oran-srfr/k-car-stm32f103c8t6/_k_figs/image12.png

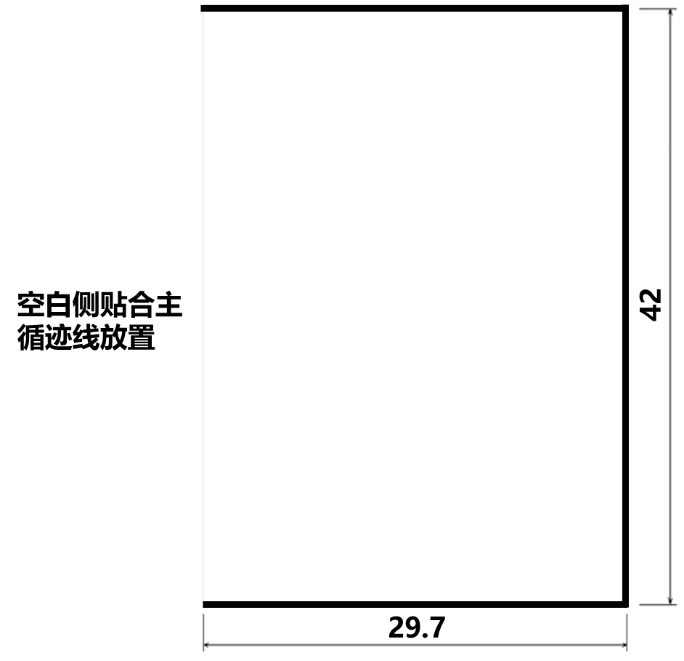
_k_figs/image12.png
