oran-srfr/k-car-stm32f103c8t6/firmware/Core/Src/line_follow.c

#include "line_follow.h"

#include <math.h>
#include <stddef.h>
#include <stdint.h>

static LineFollowState_t s_state = LINE_FOLLOW_STOPPED;
static LineFollowFault_t s_fault = LINE_FOLLOW_FAULT_NONE;
static float s_last_valid_deviation = 0.0f;
static int8_t s_last_valid_direction = 0;
static uint8_t s_has_valid_history = 0U;
static uint16_t s_lost_cycles = 0U;
static uint16_t s_reacquire_cycles = 0U;
static float s_previous_base_speed = 0.0f;
static float s_reacquire_start_base = 0.0f;
static uint16_t s_curve_hold_cycles = 0U;
static uint16_t s_centered_cycles = 0U;
static float s_previous_correction = 0.0f;
static LineFollowResult_t s_latest_output;

static void LineFollow_ResetState(LineFollowState_t state)
{
  s_state = state;
  s_fault = LINE_FOLLOW_FAULT_NONE;
  s_last_valid_deviation = 0.0f;
  s_last_valid_direction = 0;
  s_has_valid_history = 0U;
  s_lost_cycles = 0U;
  s_reacquire_cycles = 0U;
  s_previous_base_speed = 0.0f;
  s_reacquire_start_base = 0.0f;
  s_curve_hold_cycles = 0U;
  s_centered_cycles = 0U;
  s_previous_correction = 0.0f;

  s_latest_output = (LineFollowResult_t){0};
  s_latest_output.state = state;
  s_latest_output.control.track.status = LINE_TRACK_STATUS_LOST;
  s_latest_output.control.pd.status = LINE_TRACK_STATUS_LOST;
  s_latest_output.control.control_status = LINE_CONTROL_STATUS_DISABLED_STOP;
  PDController_Reset();
}

static uint8_t LineFollow_ConfigIsValid(const MotorCommandConfig_t *motor_config,
                                        const LineFollowConfig_t *follow_config)
{
  if ((motor_config == NULL) || (follow_config == NULL))
  {
    return 0U;
  }

  if (!isfinite(motor_config->base_speed) ||
      !isfinite(motor_config->max_forward_command) ||
      !isfinite(motor_config->min_forward_command) ||
      !isfinite(motor_config->straight_trim) ||
      !isfinite(follow_config->curve_speed) ||
      !isfinite(follow_config->sharp_curve_speed) ||
      !isfinite(follow_config->search_speed) ||
      !isfinite(follow_config->straight_max_deviation) ||
      !isfinite(follow_config->curve_max_deviation) ||
      !isfinite(follow_config->search_turn_correction))
  {
    return 0U;
  }

  if ((motor_config->min_forward_command <= 0.0f) ||
      (motor_config->max_forward_command <= motor_config->min_forward_command) ||
      (motor_config->base_speed < motor_config->min_forward_command) ||
      (motor_config->base_speed > motor_config->max_forward_command) ||
      (follow_config->curve_speed < motor_config->min_forward_command) ||
      (follow_config->curve_speed > motor_config->base_speed) ||
      (follow_config->sharp_curve_speed < motor_config->min_forward_command) ||
      (follow_config->sharp_curve_speed > follow_config->curve_speed) ||
      (follow_config->search_speed < motor_config->min_forward_command) ||
      (follow_config->search_speed > motor_config->max_forward_command) ||
      (follow_config->straight_max_deviation < 0.0f) ||
      (follow_config->curve_max_deviation < follow_config->straight_max_deviation) ||
      (follow_config->search_turn_correction < 0.0f))
  {
    return 0U;
  }

  return 1U;
}

static float LineFollow_SelectBaseSpeed(float deviation,
                                        const MotorCommandConfig_t *motor_config,
                                        const LineFollowConfig_t *follow_config)
{
  float absolute_deviation = fabsf(deviation);

  if (absolute_deviation <= follow_config->straight_max_deviation)
  {
    /* Centered samples occur throughout an arc; do not accelerate on each. */
    if (s_curve_hold_cycles > 0U)
    {
      --s_curve_hold_cycles;
      return follow_config->curve_speed;
    }
    return motor_config->base_speed;
  }
  s_curve_hold_cycles = LINE_FOLLOW_CURVE_HOLD_CYCLES;
  if (absolute_deviation <= follow_config->curve_max_deviation)
  {
    return follow_config->curve_speed;
  }
  return follow_config->sharp_curve_speed;
}

/* Rate limit steering, not individual wheels: stale steering must never keep
 * pointing away from a line that has reappeared on the opposite side. */
static float LineFollow_LimitCorrection(float target)
{
  float delta;
  if (target * s_previous_correction < 0.0f) {
    s_previous_correction = 0.0f;
  }
  delta = target - s_previous_correction;
  if (delta > LINE_FOLLOW_CORRECTION_STEP) delta = LINE_FOLLOW_CORRECTION_STEP;
  if (delta < -LINE_FOLLOW_CORRECTION_STEP) delta = -LINE_FOLLOW_CORRECTION_STEP;
  s_previous_correction += delta;
  return s_previous_correction;
}

static MotorCommandResult_t LineFollow_MakeCommand(float base_speed,
                                                    float correction,
                                                    const MotorCommandConfig_t *motor_config)
{
  MotorCommandConfig_t command_config = *motor_config;

  command_config.base_speed = base_speed;
  /* 找线命令由状态机授权，仍复用已有左右轮混合和限幅函数。 */
  return MotorCommand_Calculate(LINE_TRACK_STATUS_NORMAL,
                                LineFollow_LimitCorrection(correction),
                                &command_config);
}

static void LineFollow_SetFault(LineFollowFault_t fault,
                                LineFollowResult_t *result)
{
  s_state = LINE_FOLLOW_FAULT;
  s_fault = fault;
  s_reacquire_cycles = 0U;
  s_previous_correction = 0.0f;
  result->base_speed = 0.0f;
  result->left_command = 0.0f;
  result->right_command = 0.0f;
}

static void LineFollow_UpdateLastDeviation(float deviation)
{
  s_last_valid_deviation = deviation;
  s_has_valid_history = 1U;

  if (deviation < 0.0f)
  {
    s_last_valid_direction = -1;
    s_centered_cycles = 0U;
  }
  else if (deviation > 0.0f)
  {
    s_last_valid_direction = 1;
    s_centered_cycles = 0U;
  }
  else {
    if (s_centered_cycles < LINE_FOLLOW_DIRECTION_HOLD_CYCLES) ++s_centered_cycles;
    if (s_centered_cycles >= LINE_FOLLOW_DIRECTION_HOLD_CYCLES) {
      s_last_valid_direction = 0;
    }
  }
  /* Keep direction through short centered arc samples, but expire it after
   * a sustained straight. A later gap must not resurrect an old bend. */
}

static void LineFollow_HandleLost(const MotorCommandConfig_t *motor_config,
                                  const LineFollowConfig_t *follow_config,
                                  LineFollowResult_t *result)
{
  MotorCommandResult_t motor;
  float search_correction;

  if (s_has_valid_history == 0U)
  {
    LineFollow_SetFault(LINE_FOLLOW_FAULT_NO_VALID_HISTORY, result);
    return;
  }

  if (s_lost_cycles < UINT16_MAX)
  {
    ++s_lost_cycles;
  }

  if (s_lost_cycles > follow_config->max_lost_cycles)
  {
    LineFollow_SetFault(LINE_FOLLOW_FAULT_LOST_TIMEOUT, result);
    return;
  }

  s_state = (s_lost_cycles == 1U) ? LINE_FOLLOW_LINE_LOST
                                  : LINE_FOLLOW_SEARCHING;
  s_reacquire_cycles = 0U;
  s_centered_cycles = 0U;
  result->base_speed = follow_config->search_speed;
  search_correction = follow_config->search_turn_correction *
                      (float)s_last_valid_direction;
  motor = LineFollow_MakeCommand(result->base_speed,
                                 search_correction,
                                 motor_config);
  result->left_command = motor.left_command;
  result->right_command = motor.right_command;
}

static void LineFollow_HandleNormal(const MotorCommandConfig_t *motor_config,
                                    const LineFollowConfig_t *follow_config,
                                    LineFollowResult_t *result)
{
  MotorCommandResult_t motor;
  float target_base;
  float alpha;

  target_base = LineFollow_SelectBaseSpeed(result->control.track.deviation,
                                           motor_config,
                                           follow_config);

  if ((s_state == LINE_FOLLOW_LINE_LOST) ||
      (s_state == LINE_FOLLOW_SEARCHING))
  {
    s_state = LINE_FOLLOW_REACQUIRE;
    s_reacquire_cycles = 0U;
    s_reacquire_start_base = s_previous_base_speed;
  }

  LineFollow_UpdateLastDeviation(result->control.track.deviation);

  if (s_state != LINE_FOLLOW_REACQUIRE)
  {
    s_state = LINE_FOLLOW_TRACKING;
    s_lost_cycles = 0U;
    if ((s_previous_base_speed > 0.0f) &&
        (target_base > s_previous_base_speed + LINE_FOLLOW_BASE_STEP))
    {
      target_base = s_previous_base_speed + LINE_FOLLOW_BASE_STEP;
    }
    motor = LineFollow_MakeCommand(target_base, result->control.pd.output,
                                    motor_config);
    result->base_speed = target_base;
    result->left_command = motor.left_command;
    result->right_command = motor.right_command;
    return;
  }

  if (follow_config->reacquire_cycles == 0U)
  {
    alpha = 1.0f;
  }
  else
  {
    if (s_reacquire_cycles < UINT16_MAX)
    {
      ++s_reacquire_cycles;
    }
    alpha = (float)s_reacquire_cycles /
            (float)follow_config->reacquire_cycles;
    if (alpha > 1.0f)
    {
      alpha = 1.0f;
    }
  }

  result->base_speed = s_reacquire_start_base +
                       alpha * (target_base - s_reacquire_start_base);
  /* Smooth only forward speed. Blending old wheel commands can keep turning
   * toward the lost-line side even after the line reappears on the other side. */
  motor = LineFollow_MakeCommand(result->base_speed, result->control.pd.output,
                                  motor_config);
  result->left_command = motor.left_command;
  result->right_command = motor.right_command;

  if ((follow_config->reacquire_cycles == 0U) ||
      (s_reacquire_cycles >= follow_config->reacquire_cycles))
  {
    s_state = LINE_FOLLOW_TRACKING;
    s_lost_cycles = 0U;
  }
}

/** 初始化后保持停止，防止复位后产生非零命令。 */
void LineFollow_Init(void)
{
  LineFollow_ResetState(LINE_FOLLOW_STOPPED);
}

/** 清除状态机历史并等待下一次有效采样。 */
void LineFollow_Start(void)
{
  LineFollow_ResetState(LINE_FOLLOW_TRACKING);
}

/** 停止状态机并清除所有可输出的软件命令历史。 */
void LineFollow_Stop(void)
{
  LineFollow_ResetState(LINE_FOLLOW_STOPPED);
}

/** 执行一次循迹状态机，不访问 PWM、方向 GPIO 或电机驱动。 */
LineFollowResult_t LineFollow_Update(const PDControllerConfig_t *pd_config,
                                     const MotorCommandConfig_t *motor_config,
                                     const LineFollowConfig_t *follow_config)
{
  LineFollowResult_t result;

  result.control = LineControl_Sample(pd_config);
  result.base_speed = 0.0f;
  result.left_command = 0.0f;
  result.right_command = 0.0f;

  if (s_state == LINE_FOLLOW_STOPPED)
  {
    /* 保持采样供调试观察，但停止状态绝不生成轮命令。 */
  }
  else if (s_state == LINE_FOLLOW_FAULT)
  {
    /* 故障锁存，必须重新 Start 或先 Stop 后再 Start。 */
  }
  else if (result.control.track.status == LINE_TRACK_STATUS_ALL_BLACK)
  {
    LineFollow_SetFault(LINE_FOLLOW_FAULT_ALL_BLACK, &result);
  }
  else if ((LineFollow_ConfigIsValid(motor_config, follow_config) == 0U) ||
           (result.control.control_status == LINE_CONTROL_STATUS_INVALID_INPUT_STOP))
  {
    LineFollow_SetFault(LINE_FOLLOW_FAULT_INVALID_INPUT, &result);
  }
  else if (result.control.track.status == LINE_TRACK_STATUS_LOST)
  {
    LineFollow_HandleLost(motor_config, follow_config, &result);
  }
  else if (result.control.track.status == LINE_TRACK_STATUS_NORMAL)
  {
    LineFollow_HandleNormal(motor_config, follow_config, &result);
  }
  else
  {
    LineFollow_SetFault(LINE_FOLLOW_FAULT_INVALID_INPUT, &result);
  }

  s_previous_base_speed = result.base_speed;

  result.state = s_state;
  result.fault = s_fault;
  result.last_valid_deviation = s_last_valid_deviation;
  result.last_valid_direction = s_last_valid_direction;
  result.lost_cycles = s_lost_cycles;
  result.reacquire_cycles = s_reacquire_cycles;
  s_latest_output = result;
  return result;
}

/** 读取缓存结果，不触发新的传感器采样或控制运算。 */
LineFollowResult_t LineFollow_GetOutput(void)
{
  return s_latest_output;
}
