oran-srfr/k-car-stm32f103c8t6/firmware/Core/Inc/lcdfont.h

/* ============================================================================
 * lcdfont.h —— 8x16 ASCII 点阵字库（96 个可打印字符）
 *
 * 来源：1.8 寸 TFT 参考包 lcdfont.h，只保留 8x16 一套。
 * 原包还有 6x12 / 12x24 / 16x32 三套，全编进来约 12.2KB，64KB Flash 下没必要，
 * 需要时再放开。中文不在这里 —— 中文走外部字库芯片（zk.c）。
 *
 * 每个字符 16 字节：高 8 位在前，从左到右按列扫描，共 8 列 x 16 行。
 * ========================================================================== */

#ifndef __LCDFONT_H
#define __LCDFONT_H
const unsigned char ascii_1608[][16] =
{
	{0x00, 0x00, 0x00, 0x00, 0x00, 0x00, 0x00, 0x00, 0x00, 0x00, 0x00, 0x00, 0x00, 0x00, 0x00, 0x00}, /*" ",0*/
	{0x00, 0x00, 0x00, 0x08, 0x08, 0x08, 0x08, 0x08, 0x08, 0x08, 0x00, 0x00, 0x18, 0x18, 0x00, 0x00}, /*"!",1*/
	{0x00, 0x48, 0x6C, 0x24, 0x12, 0x00, 0x00, 0x00, 0x00, 0x00, 0x00, 0x00, 0x00, 0x00, 0x00, 0x00}, /*""",2*/
	{0x00, 0x00, 0x00, 0x24, 0x24, 0x24, 0x7F, 0x12, 0x12, 0x12, 0x7F, 0x12, 0x12, 0x12, 0x00, 0x00}, /*"#",3*/
	{0x00, 0x00, 0x08, 0x1C, 0x2A, 0x2A, 0x0A, 0x0C, 0x18, 0x28, 0x28, 0x2A, 0x2A, 0x1C, 0x08, 0x08}, /*"$",4*/
	{0x00, 0x00, 0x00, 0x22, 0x25, 0x15, 0x15, 0x15, 0x2A, 0x58, 0x54, 0x54, 0x54, 0x22, 0x00, 0x00}, /*"%",5*/
	{0x00, 0x00, 0x00, 0x0C, 0x12, 0x12, 0x12, 0x0A, 0x76, 0x25, 0x29, 0x11, 0x91, 0x6E, 0x00, 0x00}, /*"&",6*/
	{0x00, 0x06, 0x06, 0x04, 0x03, 0x00, 0x00, 0x00, 0x00, 0x00, 0x00, 0x00, 0x00, 0x00, 0x00, 0x00}, /*"'",7*/
	{0x00, 0x40, 0x20, 0x10, 0x10, 0x08, 0x08, 0x08, 0x08, 0x08, 0x08, 0x10, 0x10, 0x20, 0x40, 0x00}, /*"(",8*/
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
	{0x00, 0x00, 0x00, 0x3F, 0x42, 0x12, 0x12, 0x1E, 0x12, 0x12, 0x02, 0x02, 0x02, 0x07, 0x00, 0x00}, /*"F",38*/
	{0x00, 0x00, 0x00, 0x3C, 0x22, 0x22, 0x01, 0x01, 0x01, 0x71, 0x21, 0x22, 0x22, 0x1C, 0x00, 0x00}, /*"G",39*/
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
};
#endif /* __LCDFONT_H */
