oran-srfr/k-car-stm32f103c8t6/firmware/tests/test_tracking.c

#include "line_track.h"
#include "motor_command.h"
#include "pd_controller.h"

#include <assert.h>
#include <math.h>
#include <stdio.h>

static void test_line_track(void)
{
    LineTrackResult_t r;

    r = LineTrack_Calculate(0x0FU);
    assert(r.status == LINE_TRACK_STATUS_LOST);
    assert(r.black_bits == 0U);

    r = LineTrack_Calculate(0x00U);
    assert(r.status == LINE_TRACK_STATUS_ALL_BLACK);

    /* X1 and X3 are the two inner sensors, so their pair is centered. */
    r = LineTrack_Calculate(0x0AU);
    assert(r.status == LINE_TRACK_STATUS_NORMAL);
    assert(r.black_bits == 0x06U);
    assert(r.deviation == 0.0f);

    r = LineTrack_Calculate(0x0DU);
    assert(r.black_bits == 0x01U);
    assert(r.deviation == -3.0f);

    r = LineTrack_Calculate(0x07U);
    assert(r.black_bits == 0x08U);
    assert(r.deviation == 3.0f);
}

static void test_pd(void)
{
    PDControllerConfig_t config = { 2.0f, 10.0f, 100.0f };
    PDControllerResult_t r;

    PDController_Reset();
    r = PDController_Calculate(LINE_TRACK_STATUS_NORMAL, 1.0f, &config);
    assert(r.status == LINE_TRACK_STATUS_NORMAL);
    assert(r.output == 2.0f);
    assert(r.derivative == 0.0f);

    r = PDController_Calculate(LINE_TRACK_STATUS_NORMAL, 2.0f, &config);
    assert(r.derivative > 0.0f);
    assert(r.output > 2.0f);
    assert(r.output <= config.output_limit);

    r = PDController_Calculate(LINE_TRACK_STATUS_LOST, 5.0f, &config);
    assert(r.output == 0.0f);
}

static void test_motor_command(void)
{
    MotorCommandConfig_t config = { 20.0f, 100.0f, 0.0f, 0.0f };
    MotorCommandResult_t r;

    r = MotorCommand_Calculate(LINE_TRACK_STATUS_NORMAL, 5.0f, &config);
    assert(r.left_command == 25.0f);
    assert(r.right_command == 15.0f);

    r = MotorCommand_Calculate(LINE_TRACK_STATUS_NORMAL, 200.0f, &config);
    assert(r.left_command == 100.0f);
    assert(r.right_command == 0.0f);

    config = (MotorCommandConfig_t){650.0f, 800.0f, 550.0f, 0.0f};
    for (int correction = -500; correction <= 500; ++correction) {
        r = MotorCommand_Calculate(LINE_TRACK_STATUS_NORMAL, (float)correction, &config);
        assert(r.left_command >= 550.0f && r.left_command <= 800.0f);
        assert(r.right_command >= 550.0f && r.right_command <= 800.0f);
        assert((r.left_command - r.right_command) * correction >= 0.0f);
    }
    config.straight_trim = 10.0f;
    r = MotorCommand_Calculate(LINE_TRACK_STATUS_NORMAL, 0.0f, &config);
    assert(r.left_command == 660.0f && r.right_command == 640.0f);
    config.base_speed = 0.0f;
    r = MotorCommand_Calculate(LINE_TRACK_STATUS_NORMAL, 0.0f, &config);
    assert(r.left_command == 0.0f && r.right_command == 0.0f);
    config.base_speed = 650.0f;
    config.min_forward_command = NAN;
    r = MotorCommand_Calculate(LINE_TRACK_STATUS_NORMAL, 0.0f, &config);
    assert(r.left_command == 0.0f && r.right_command == 0.0f);

    r = MotorCommand_Calculate(LINE_TRACK_STATUS_LOST, 5.0f, &config);
    assert(r.left_command == 0.0f);
    assert(r.right_command == 0.0f);
}

int main(void)
{
    test_line_track();
    test_pd();
    test_motor_command();
    puts("PASS: tracking geometry, PD, and motor mixing");
    return 0;
}
