oran-srfr/k-car-stm32f103c8t6/(commit log)

2026-10-26 Initial STM32F103C8T6 smart car project
2026-10-26 Add competition application framework and module interfaces
2026-10-26 Add nonblocking HC-SR04 driver using TIM4 and PA4/PA5
2026-10-26 Add nonblocking TIM2 buzzer patterns and event integration
    [app_modules.c, buzzer.c, buzzer.h, buzzer_port.h, buzzer_stm32.c, test_buzzer.c]
2026-10-27 Integrate line following and fix active-low buzzer
    [app_modules.c, board_pins.h, buzzer_port.h, buzzer_stm32.c, control_config.h, line_control.c, line_control.h, line_follow.c]
2026-10-29 Stabilize forward line tracking within 55-80 percent PWM
    [app_modules.c, board_pins.h, control_config.h, line_control.c, line_follow.c, line_follow.h, line_track.c, line_track.h]
2026-10-29 Document confirmed SW-to-X sensor wiring
2026-10-29 Use smooth forward steering for straight lines and R60 arcs
